domyshev/3d-models/models/magsafe_holder/THIRD_PARTY_NOTICES.md

# Third-Party Notices

## Dan Kirshner `threads.scad`

- Author: Dan Kirshner (`dan_kirshner@yahoo.com`)
- File: `src/vendor/dan-kirshner-threads/2.7/threads.scad`
- Version: 2.7 (2022-02-27)
- License: GNU General Public License, version 3 or later
- SHA-256: `e6e97bac49814bec33ecdbe8641664497b6989455d84bdba0282e5f6562fb600`
- Local modifications: none

The v0.3 source snapshot also vendors this library under
`releases/v0.3/src/components/shared/vendor/dan-kirshner-threads/2.7/threads.scad`.
The reusable component library keeps a copy under
`../../details/shared/vendor/dan-kirshner-threads/2.7/threads.scad`.

The original download URL is not embedded in the vendored file. A matching
public copy of version 2.7 is available at:

<https://github.com/verhas/OpenScad/blob/main/threads.scad>

The library provides the `metric_thread()` implementation used for the
model's internal and external printed threads. Its copyright and license
header has been preserved in the vendored source file. A complete copy of the
GNU GPLv3 is included in this repository at
[`../../LICENSES/GPL-3.0-or-later.txt`](../../LICENSES/GPL-3.0-or-later.txt).
