domyshev/3d-models/models/magsafe_holder/LICENSING_PLANS.md

# Historical licensing plans — not applicable to current releases

This document preserves the previously published future licensing proposal.
It is not the license for the current distribution and imposes no additional
conditions on GPL-covered releases. No transition date or version is promised.
Permissions already granted under the GPL are not revoked by a future change.
See [LICENSE](LICENSE) for the current license.

## Archived proposal

```text
Custom Individual and Community Source License, Version 1.0
An Individual-First, Maker-First Source-Available License

Copyright (c) 2026 Ilia Domyshev
All rights reserved except as expressly granted below.

Temporary GPLv3-or-later release notice

The current release of the Work uses and depends on Dan Kirshner's
`threads.scad`, version 2.7, which is licensed under the GNU General Public
License, version 3 or (at the recipient's option) any later version.

Accordingly, for every release of the Work that contains, incorporates, or is
designed to use that GPL-covered library, the copyright holder licenses the
Work under the GNU General Public License, version 3 or any later version.
Notwithstanding any conflicting term below, the GNU GPL governs such a
release and takes precedence. In particular, the restrictions on use by
Organizations and other non-GPL restrictions below do not apply to that
GPL-covered release.

The individual-first and maker-first terms below record the copyright
holder's intended licensing model for a future release. They are not
additional restrictions on a release governed by the GNU GPL.

The copyright holder intends to replace the GPL-covered threading dependency
with either an independently developed implementation or a suitable library
whose licensing terms permit the intended transition. The target transition
date or version has not yet been determined and will be announced separately.
A later release that no longer contains, incorporates, or depends on
incompatibly licensed code may be offered under the individual-first and
maker-first terms below. Such a change will not revoke or restrict GNU GPL
permissions already granted for earlier releases.

A copy of the GNU General Public License, version 3, is included at
`../../LICENSES/GPL-3.0-or-later.txt` and is also available at:
https://www.gnu.org/licenses/gpl-3.0.html

Purpose and character

This is an individual-first, maker-first source-available license. It is
intended to keep editable design sources available, to enable natural persons
and independent makers to study, adapt, manufacture, share, and earn from the
Work, and to reserve use by companies and other organizations for a separate
agreement with the copyright holder.

The phrases "individual-first" and "maker-first" describe the priorities of
this license. They do not claim recognition as a standard, certification, or
affiliation with any external licensing initiative. The legally operative
rights and restrictions are those stated in the numbered sections below.

1. Definitions

"Work" means the source files, parametric models, documentation, mesh files,
and other materials distributed with this license, including modified and
derived versions of those materials.

"Individual" means a natural person acting solely on their own behalf and not
on behalf of, at the direction of, or for the benefit of an organization or
legal entity.

"Organization" means any company, corporation, partnership, association,
nonprofit organization, government body, educational institution, employer,
or other legal entity or organized group.

2. License grant to individuals

Subject to the conditions of this license, the copyright holder grants an
Individual a worldwide, non-exclusive, royalty-free, non-transferable license
to:

a. use, study, copy, and print the Work;
b. modify the Work and create derivative works;
c. distribute the Work, printed objects made from the Work, and derivative
   works; and
d. use the Work commercially in the Individual's own name, provided that the
   Individual is not acting for or on behalf of an Organization.

3. Source-sharing and attribution conditions

When an Individual distributes a modified or derivative version of the Work,
the complete corresponding editable source files must be made available under
this same license at no additional charge.

All distributions of the Work or derivative works must retain this license,
the copyright notice, and reasonable attribution to the original author.
Modifications must be clearly identified as modifications and must not be
presented as an official version produced by the original author.

4. Organizations and companies

No rights are granted by this license to an Organization.

Any use, copying, modification, manufacture, printing, distribution, sale, or
other exploitation of the Work by or on behalf of an Organization requires a
separate prior written agreement with the copyright holder.

Permission granted to an Individual does not extend to the Individual's
employer, client, company, or any other Organization.

5. No sublicensing or relicensing

The Work and derivative works may not be sublicensed or relicensed under
different terms without the copyright holder's prior written permission.

6. Termination

Any rights granted under this license terminate automatically upon violation
of its terms. Continued possession, use, manufacture, or distribution after
termination is not permitted unless the copyright holder provides written
reinstatement.

7. Disclaimer of warranty

THE WORK IS PROVIDED "AS IS", WITHOUT WARRANTY OF ANY KIND, EXPRESS OR
IMPLIED, INCLUDING BUT NOT LIMITED TO WARRANTIES OF MERCHANTABILITY, FITNESS
FOR A PARTICULAR PURPOSE, TITLE, AND NON-INFRINGEMENT. THE USER ASSUMES ALL
RISK ARISING FROM USE, PRINTING, ASSEMBLY, OR OPERATION OF THE WORK.

8. Limitation of liability

TO THE MAXIMUM EXTENT PERMITTED BY LAW, THE COPYRIGHT HOLDER SHALL NOT BE
LIABLE FOR ANY CLAIM, DAMAGES, PERSONAL INJURY, PROPERTY DAMAGE, DATA LOSS, OR
OTHER LIABILITY ARISING FROM OR RELATED TO THE WORK OR ITS USE, WHETHER IN
CONTRACT, TORT, OR OTHERWISE.

9. Written permission

Any exception, commercial organization license, or other permission must be
expressly granted in writing by the copyright holder. Silence, publication of
the Work, or acceptance of contributions does not constitute permission.
```
