domyshev/3d-models/models/magsafe_holder/releases/v0.3/bambu/magsafe_holder_v0.3_a1_mini.3mf

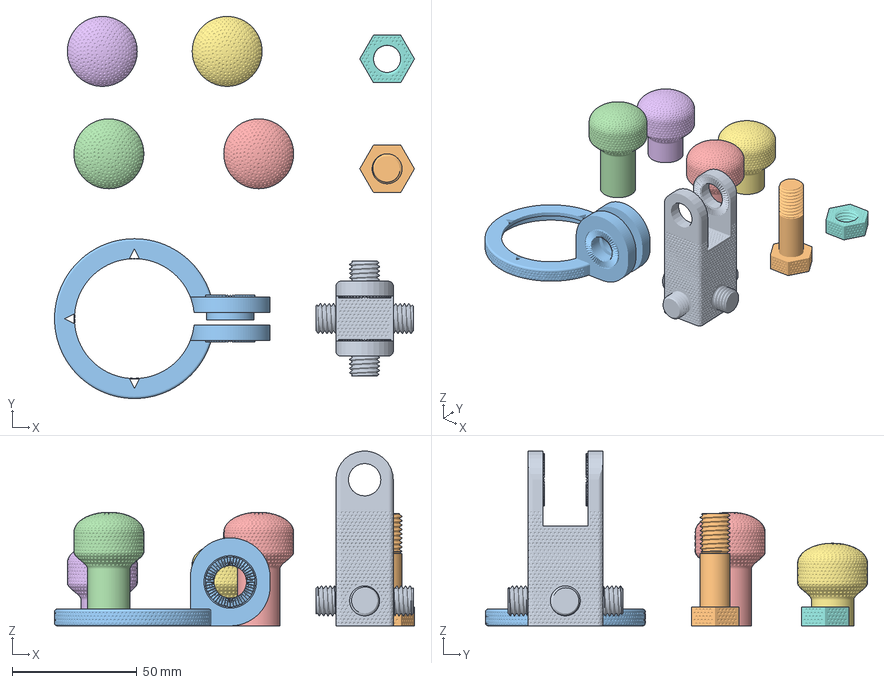
[picture p13: CAD file, 2026-10-30]
models/magsafe_holder/releases/v0.3/bambu/magsafe_holder_v0.3_a1_mini.3mf
144.2 x 153.0 x 69.9 mm
support.stl
bolt.stl
ring.stl
leg_x.stl x 2
leg_y.stl x 2
nut.stl
