domyshev/3d-models/models/magsafe_holder/releases/v0.3/stl/leg_x.stl

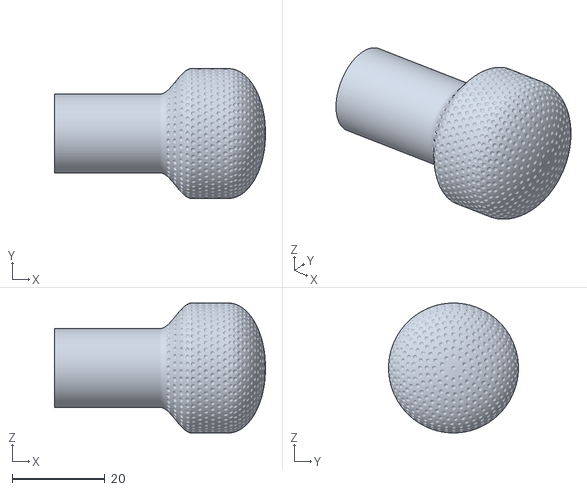
[picture p14: CAD file, 2026-10-30]
models/magsafe_holder/releases/v0.3/stl/leg_x.stl
45.5 x 28.0 x 28.0
