domyshev/3d-models/models/magsafe_holder/releases/v0.3/stl/leg_y.stl

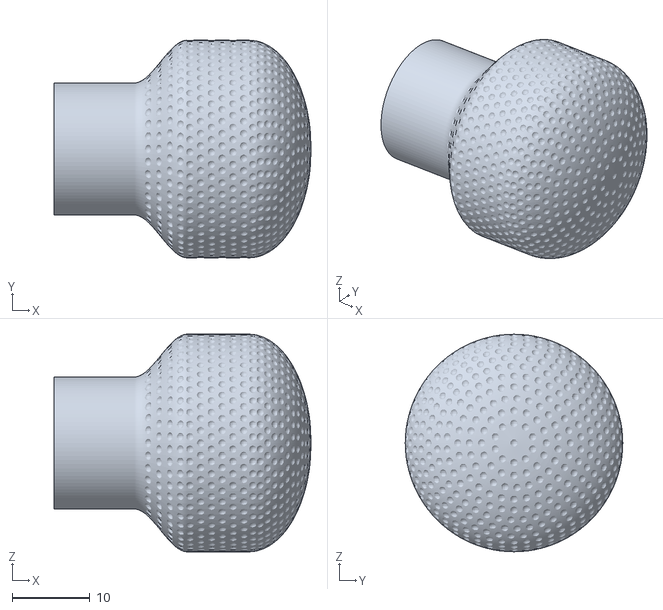
[picture p15: CAD file, 2026-10-30]
models/magsafe_holder/releases/v0.3/stl/leg_y.stl
33.1 x 28.0 x 28.0
