domyshev/3d-models/models/magsafe_holder/releases/v0.3/stl/support.stl

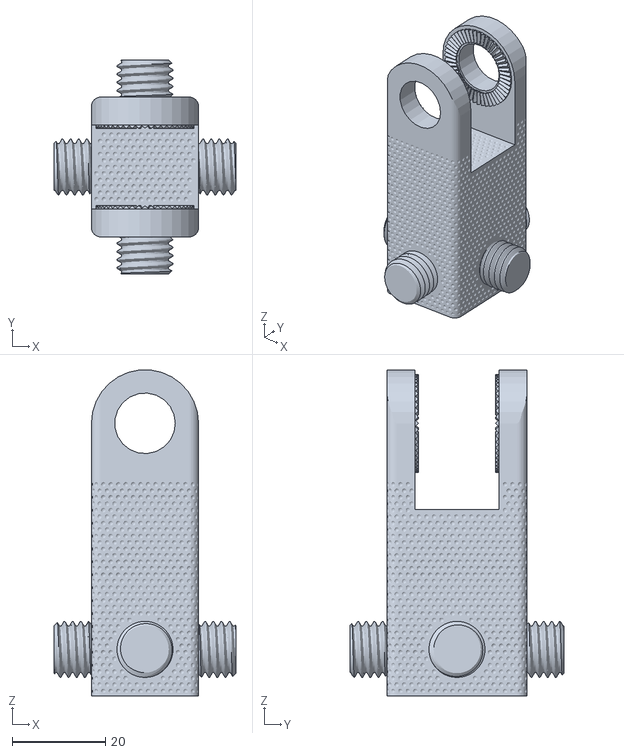
[picture p16: CAD file, 2026-10-30]
models/magsafe_holder/releases/v0.3/stl/support.stl
39.0 x 46.0 x 69.9
