domyshev/3d-models/models/magsafe_holder/releases/v0.3/stl/ring.stl

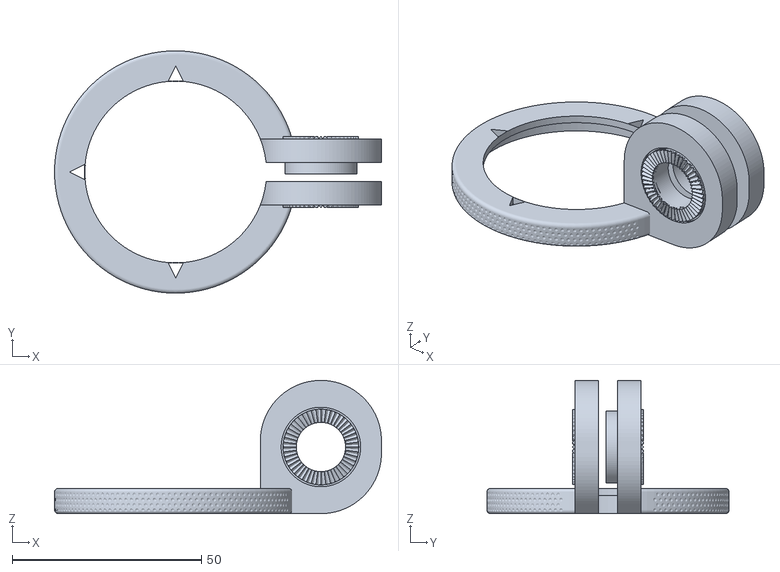
[picture p17: CAD file, 2026-10-30]
models/magsafe_holder/releases/v0.3/stl/ring.stl
86.4 x 64.0 x 35.2
