domyshev/3d-models/models/magsafe_holder/releases/v0.3/stl/bolt.stl

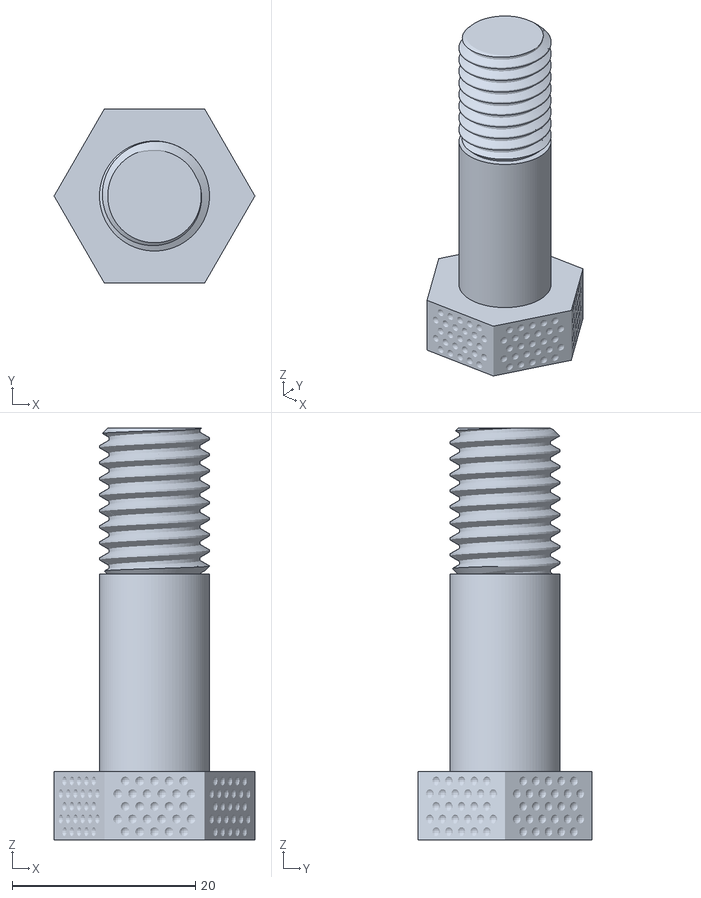
[picture p18: CAD file, 2026-10-30]
models/magsafe_holder/releases/v0.3/stl/bolt.stl
21.9 x 19.0 x 45.0
