domyshev/3d-models/models/magsafe_holder/releases/v0.3/stl/nut.stl

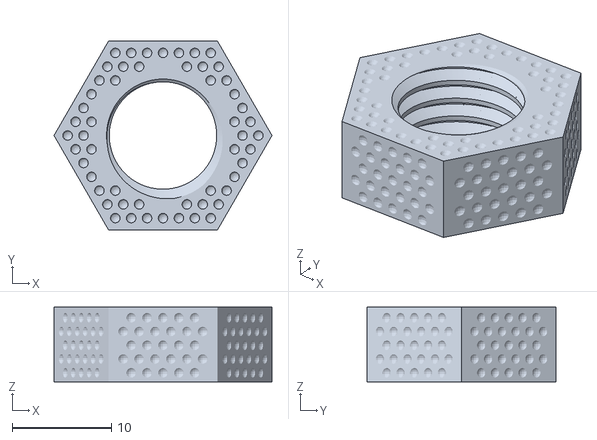
[picture p19: CAD file, 2026-10-30]
models/magsafe_holder/releases/v0.3/stl/nut.stl
21.9 x 19.0 x 7.50
