domyshev/3d-models/models/magsafe_holder/releases/v0.2/full-height/bambu/magsafe_holder_full_height_v0.2_a1_mini.3mf

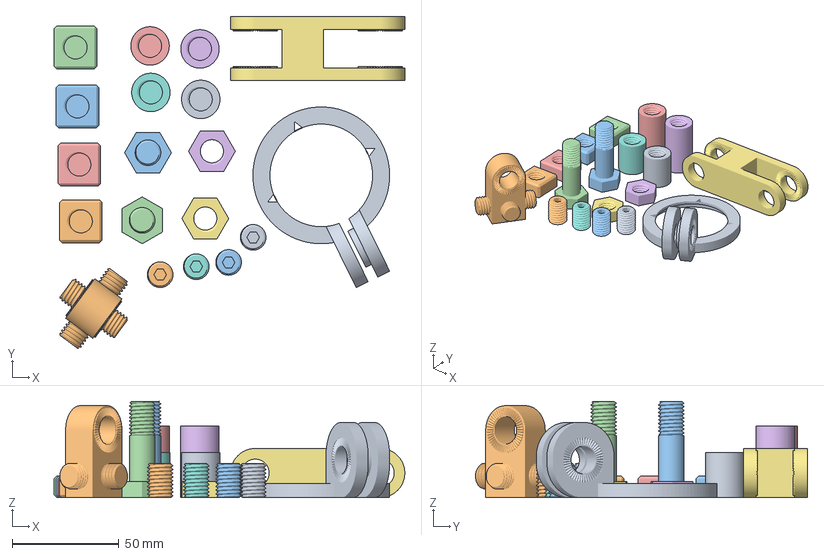
[picture p20: CAD file, 2026-08-25, an earlier design]
models/magsafe_holder/releases/v0.2/full-height/bambu/magsafe_holder_full_height_v0.2_a1_mini.3mf
164.1 x 155.4 x 45.0 mm
magsafe_clamp_ring.stl
threaded_base.stl
m12_long_bolt.stl x 2
long_sleeve.stl x 2
vertical_support.stl
short_sleeve.stl x 2
threaded_end_block.stl x 4
m12_nut.stl x 2
m12_hex_socket_connector.stl x 4
