domyshev/3d-models/models/magsafe_holder/releases/v0.2/full-height/stl/full_height_threaded_base.stl

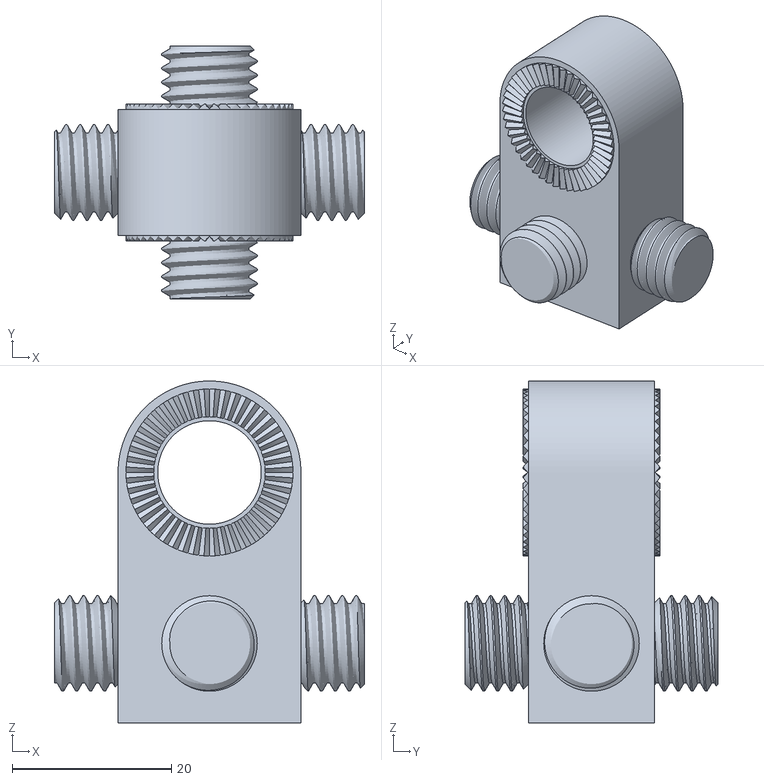
[picture p21: CAD file, 2026-08-21, an earlier design]
models/magsafe_holder/releases/v0.2/full-height/stl/full_height_threaded_base.stl
39.0 x 31.8 x 43.0
