domyshev/3d-models/models/magsafe_holder/releases/v0.2/compact/bambu/magsafe_holder_compact_v0.2_a1_mini.3mf

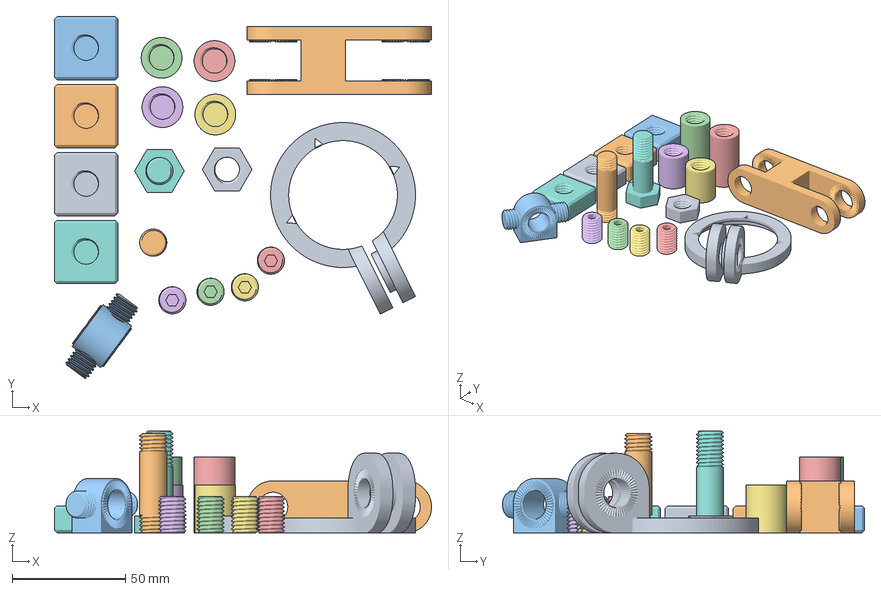
[picture p23: CAD file, 2026-08-25, an earlier design]
models/magsafe_holder/releases/v0.2/compact/bambu/magsafe_holder_compact_v0.2_a1_mini.3mf
166.5 x 159.8 x 45.0 mm
magsafe_clamp_ring.stl
vertical_support.stl
compact_threaded_base.stl
long_sleeve.stl x 2
short_sleeve.stl x 2
compact_end_block.stl x 4
m12_hex_socket_connector.stl x 4
m12_long_bolt.stl
m12_nut.stl
compact_shared_stud.stl
