domyshev/3d-models/models/magsafe_holder/releases/v0.2/compact/stl/compact_shared_stud.stl

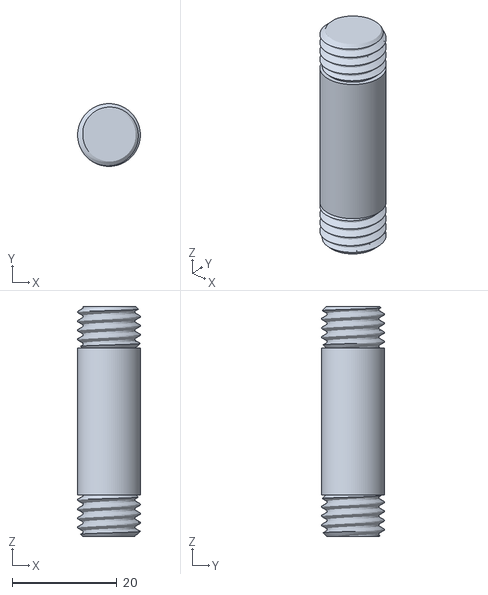
[picture p24: CAD file, 2026-08-25, an earlier design]
models/magsafe_holder/releases/v0.2/compact/stl/compact_shared_stud.stl
12.0 x 12.0 x 44.0
