domyshev/3d-models/models/magsafe_holder/releases/v0.2/full-height/stl/threaded_end_block.stl

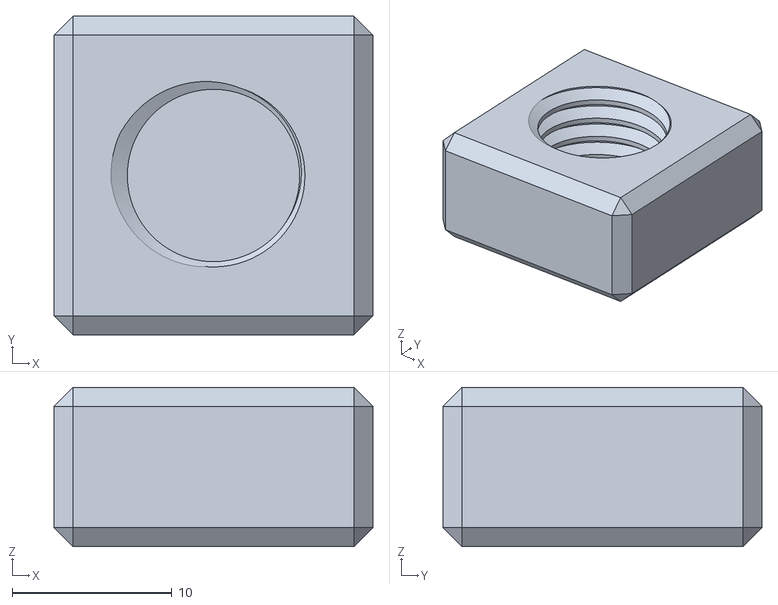
[picture p25: CAD file, 2026-08-21, an earlier design]
models/magsafe_holder/releases/v0.2/full-height/stl/threaded_end_block.stl
20.0 x 20.0 x 10.0
