domyshev/3d-models/models/magsafe_holder/releases/v0.2/shared/stl/magsafe_clamp_ring.stl

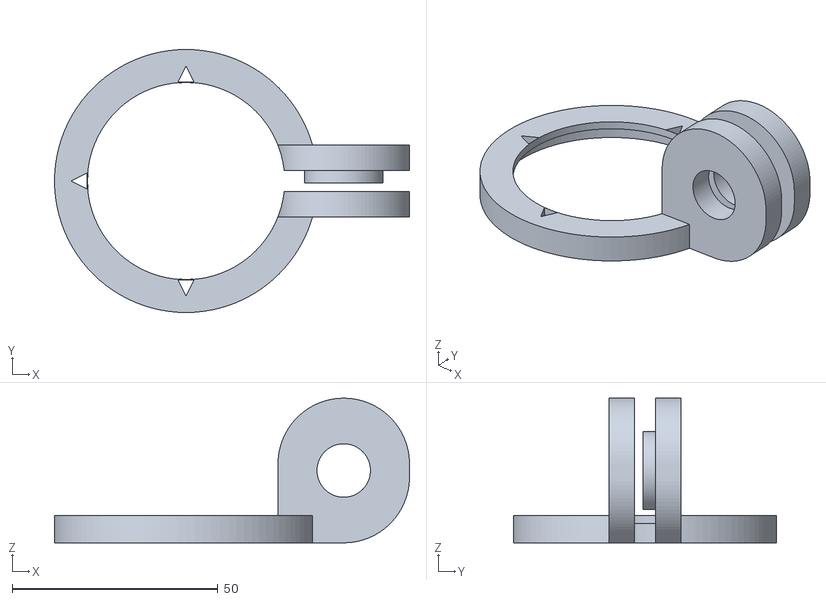
[picture p26: CAD file, 2026-08-25, an earlier design]
models/magsafe_holder/releases/v0.2/shared/stl/magsafe_clamp_ring.stl
86.4 x 64.0 x 35.2
