domyshev/3d-models/models/magsafe_holder/releases/v0.2/compact/stl/compact_end_block.stl

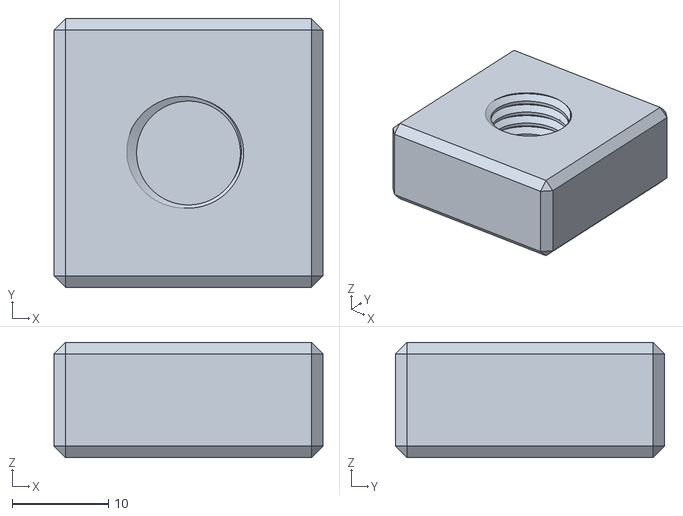
[picture p27: CAD file, 2026-08-25, an earlier design]
models/magsafe_holder/releases/v0.2/compact/stl/compact_end_block.stl
28.0 x 28.0 x 12.0
