domyshev/3d-models/models/magsafe_holder/releases/v0.2/shared/stl/short_sleeve.stl

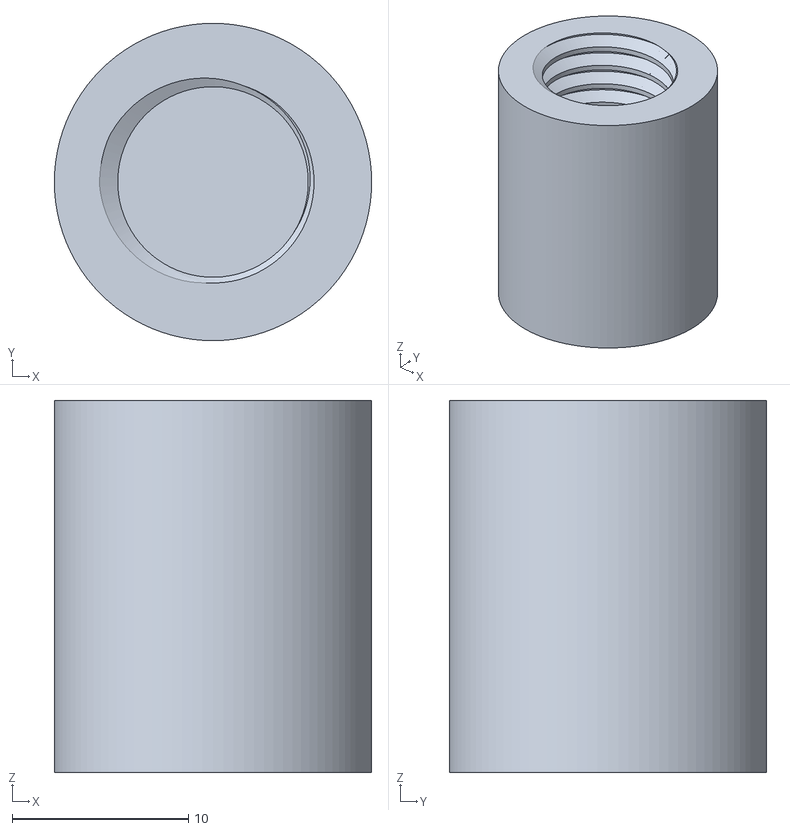
[picture p28: CAD file, 2026-08-21, an earlier design]
models/magsafe_holder/releases/v0.2/shared/stl/short_sleeve.stl
18.0 x 18.0 x 21.1
