domyshev/3d-models/models/magsafe_holder/releases/v0.2/compact/stl/compact_threaded_base.stl

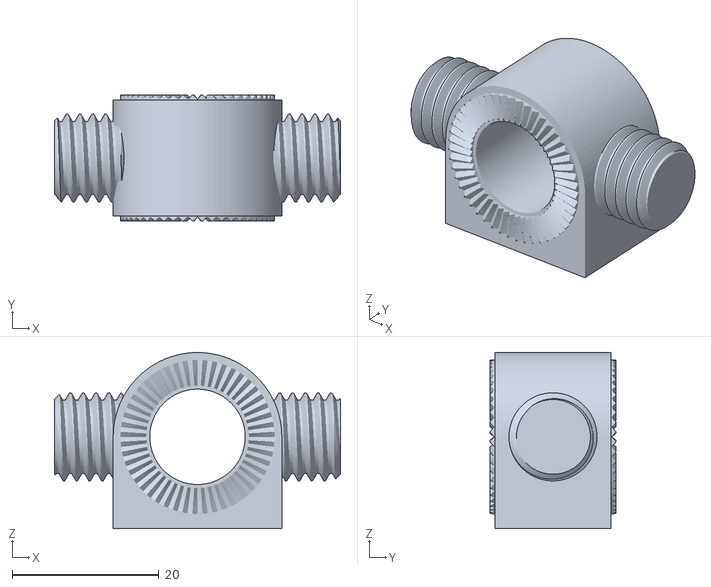
[picture p29: CAD file, 2026-08-25, an earlier design]
models/magsafe_holder/releases/v0.2/compact/stl/compact_threaded_base.stl
39.0 x 17.2 x 24.0
