domyshev/3d-models/models/magsafe_holder/releases/v0.2/shared/stl/vertical_support.stl

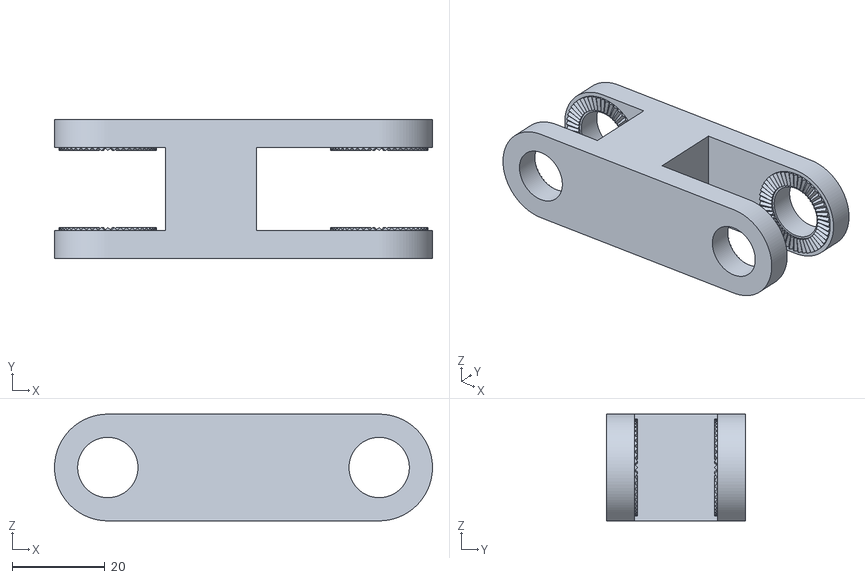
[picture p30: CAD file, 2026-08-21, an earlier design]
models/magsafe_holder/releases/v0.2/shared/stl/vertical_support.stl
81.5 x 30.0 x 23.0
