domyshev/3d-models/details/sculpted-leg/leg-x.scad

// Exact short-leg head and texture; only the smooth root is 12.4 mm longer.
include <shared/leg_geometry.scad>
sculpted_leg_extended_root(leg_x_length);
