domyshev/3d-models/details/sculpted-leg/leg-y.scad

// Short leg: 8 mm constant-diameter bearing band and a fully domed end.
include <shared/leg_geometry.scad>
sculpted_leg(leg_y_length, rounded_end = true);
