domyshev/3d-models/details/m12-clamp-fasteners/bolt-textured.scad

// Existing 37.5 mm useful-length M12 bolt, with decorative head texture only.
include <shared/fastener_geometry.scad>
clamp_bolt_textured();
