domyshev/3d-models/details/m12-clamp-fasteners/nut-textured.scad

// Existing 7.5 mm nut, with texture on the six outer faces and exposed end.
include <shared/fastener_geometry.scad>
clamp_nut_textured();
