domyshev/3d-models/details/magsafe-ring/ring-indexed.scad

// Latest experiment: two centered 20 mm toothed inserts seated in 21 mm recesses.
include <shared/ring_geometry.scad>
holder_with_index_inserts();
