domyshev/3d-models/details/magsafe-ring/ring.scad

// Plain cylindrical recesses; no indexing teeth.
include <shared/ring_geometry.scad>
holder_with_plain_recesses();
