domyshev/3d-models/details/vertical-support/leveling-stud-m6.scad

// Separate 12 mm headless M6 leveling stud; 2.4 mm-deep, 1.6 mm-wide slot.
$fn = 96;
use <support-adjustable-base.scad>
m6_leveling_stud();
