domyshev/3d-models/details/vertical-support/support-shortened.scad

// Remove 10 mm from the central column, preserving the upper fork and studs.
support_shortening = 10;
include <shared/support_geometry.scad>
detail_support();
