domyshev/3d-models/details/vertical-support/support.scad

// Original direct-base support height.
support_shortening = 0;
include <shared/support_geometry.scad>
detail_support();
