domyshev/3d-models/(list of files, cad)

Other CAD files:
models/magsafe_holder/releases/v0.3/src/components/sculpted-leg/leg-x.scad
models/magsafe_holder/releases/v0.3/src/components/sculpted-leg/leg-y.scad
models/magsafe_holder/releases/v0.3/src/components/sculpted-leg/shared/leg_geometry.scad
models/magsafe_holder/releases/v0.3/src/components/m12-clamp-fasteners/bolt-textured.scad
models/magsafe_holder/releases/v0.3/src/components/m12-clamp-fasteners/nut-textured.scad
models/magsafe_holder/releases/v0.3/src/components/magsafe-ring/ring-indexed-textured.scad
models/magsafe_holder/releases/v0.3/src/components/vertical-support/support-adjustable-base.scad
models/magsafe_holder/releases/v0.3/src/components/vertical-support/support-rounded-hollow.scad
models/magsafe_holder/releases/v0.3/src/components/m12-clamp-fasteners/shared/fastener_geometry.scad
models/magsafe_holder/releases/v0.3/src/components/magsafe-ring/shared/ring_geometry.scad
models/magsafe_holder/releases/v0.3/src/components/vertical-support/shared/support_geometry.scad
models/magsafe_holder/releases/v0.2/shared/stl/long_sleeve.stl
models/magsafe_holder/releases/v0.2/shared/stl/m12_hex_socket_connector.stl
models/magsafe_holder/releases/v0.2/shared/stl/m12_long_bolt.stl
models/magsafe_holder/releases/v0.2/shared/stl/m12_nut.stl
