domyshev/3d-models/(commit log)

2026-08-21 Release modular MagSafe holder v0.1.0
    Publish the first curated release of the modular desktop MagSafe holder. Add the parametric OpenSCAD source with presentation, assembly, labels, and individual-part selectors, together with the vendored Dan Kirshner threads.scad 2.7 dependency.\n\nInclude nine individually exportable STL artifacts and a Bambu Studio project for the Bambu Lab A1 mini containing the complete 19-piece set on one plate. The project uses the 0.20 mm Standard profile, a 0.4 mm nozzle, PolyTerra PLA, organic supports, standard 15% Grid infill for structural bodies, and reinforced 100% Zig Zag infill with five walls for threaded load-bearing parts.\n\nAdd the repository index, m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
    [long_sleeve.stl, m12_hex_socket_connector.stl, m12_long_bolt.stl, m12_nut.stl, magsafe_clamp_ring.stl, magsafe_holder.scad, magsafe_holder_v0.1_a1_mini.3mf, short_sleeve.stl]
2026-08-25 Release Modular MagSafe Holder v0.2.0
    Add selectable Full-Height and Compact configurations to the shared parametric OpenSCAD source. Introduce complementary radial indexing on the MagSafe clamp arms and upper support fork, the 24 mm compact threaded base, the 44 mm shared stud, and the 28 x 28 x 12 mm compact threaded end blocks. Remove the obsolete compact plug implementation.
    Publish twelve individually exportable STL artifacts across shared, full-height, and compact release directories. Add complete single-plate Bambu Studio projects for both variants: 19 objects for Full-Height and 18 objects for Compact, with per-object strength settings preserved.
    Update the model documentation with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
    [compact_end_block.stl, compact_shared_stud.stl, compact_threaded_base.stl, full_height_threaded_base.stl, long_sleeve.stl, m12_hex_socket_connector.stl, m12_long_bolt.stl, m12_nut.stl]
2026-08-26 Add Compact release photography
    Add four presentation-ready Compact configuration photographs covering front and rear views with the MagSafe charger installed and removed. Preserve the original IMG JPEG files locally without adding them to version control.
    Organize published model photography into compact and full-height directories, retaining the existing Full-Height images under clearer semantic names. Update the model README links and photo tables for both configurations.
    Verification: visually inspected all four processed Compact photographs, confirmed the holder geometry and product states remain legible, checked every renamed README image target, and ran git diff --cached --check.
2026-08-26 Document Compact tabletop mounting
    Clarify that the Compact holder feet are secured to the tabletop with double-sided mounting tape. Record the tested leveling correction: one tape layer at the normal contact points and a second layer beneath the affected rear foot to compensate for the observed height mismatch and rocking.
    Update both the version overview and known-observations sections while leaving the locally retained source photographs untracked.
2026-10-28 Add public STL gallery with automatic Mac publication
    Implement a Three.js gallery with newest-first source dates, recursive search, model links, download, orbit controls, wireframe, dimensions and responsive layout. Serve only regular STL files through a read-only Python API that rejects traversal, hidden files and symlinks.
    Deploy an independent unprivileged Docker container on isolated Kai with no published host ports. Add the fixed 3d.iliago.com Caddy route and both directory cards without expanding the Hermes publisher namespace. Provide audited deployment and verification operators.
    Install a Mac launch agent that detects changed exports, waits for stable contents, preserves timestam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
2026-10-28 Add light and dark burgundy gallery themes
    Replace the green palette with warm light surfaces and burgundy accents, plus a matching dark graphite and wine palette. Add an early-loading theme controller with device preference, an accessible header selector, persistent explicit choices and cross-tab updates.
    Update the STL material and floor grid when switching themes without reloading the model. Restyle the favicon and document theme behavior. Verify the frontend build, both palettes in the browser and dark-theme persistence after reload. Keep the application push pending the existing public-source authorization.
2026-10-30 Release MagSafe Holder v0.3.0
    Publish one eight-piece MagSafe holder design with the outer-textured indexed ring, hollow direct-base support without an M6 leveling socket, four rounded integral legs, and textured M12 clamp fasteners. Preserve v0.1 and both v0.2 artifact sets unchanged.
    Add the reusable component evolution library and a self-contained v0.3 source snapshot with the pinned Dan Kirshner threads.scad dependency, six binary STL files, four correctly named assembly PNG views, and updated English documentation for layout and assembled views.
    Include the complete upright-leg A1 mini Bambu project using white PolyTerra PLA, 0.20 mm layers, locally reinforced 25% infill for the suppo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
    [bolt-textured.scad, bolt.stl, fastener_geometry.scad, leg-x.scad, leg-y.scad, leg_geometry.scad, leg_x.stl, leg_y.stl]
2026-10-30 Release MagSafe Holder v0.3.1 assembly gallery
    Publish a presentation-only patch that exposes all four existing assembly renders directly on the GitHub release page and as individual PNG downloads. Update the repository index and model documentation to identify v0.3.1 as the latest patch.
    Keep source geometry, STL files, the Bambu Studio project, printer settings, and v0.3.0 history unchanged. Retain the documented physical-testing boundaries and distinguish CAD renders from real product photographs.
    Verification: compared all six STL assets, the Bambu project, and all four assembly PNG files byte-for-byte with tag v0.3.0; checked that the release notes embed four tag-pinned image URLs.
2026-10-30 Release MagSafe Holder v0.3.2 photo and compatibility guide
    Add four approved retouched photographs of the printed prototype, three charger views with caliper-based diameter and thickness annotations, and four pastel assembly renders on a neutral background. Present them in the approved order: printed holder, charger compatibility, then CAD assembly.
    Document the measured Apple MagSafe Charger outside diameter of 56 mm, gray-rim thickness of 5.5 mm, and maximum overall thickness of 5.7 mm. Remove the earlier unconfirmed protrusion measurement from compatibility prose, distinguish retouched photographs from renders, and retain the fit and physical-testing limitations.
    Update the model READM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
2026-11-01 Display embedded colors in STL models
    Render per-facet STL colors when available while preserving theme colors for ordinary models. Rebuild the local viewer bundle to verify the change.
2026-11-03 Release MagSafe Holder v0.3.3 documentation review fixes
    Simplify the current guide, separate historical designs and future licensing proposals, and clarify the existing GPL-3.0-or-later grant. Add step-by-step assembly, direct downloads, and an explicit pending physical-validation checklist.
    Keep geometry, STL exports, the Bambu project, and the inherited bed setting unchanged. No new physical test results are claimed.
2026-11-03 Release MagSafe Holder v0.3.4 documentation link fixes
    Use absolute tag-pinned links for historical artifacts omitted from the current-model ZIP. Correct release-gallery directory links while preserving file URLs, print artifacts, and pending physical-validation notes.
